Amazo123/Multi-Node-Infant-Cry-Detection/hardware_images/VIEW_ALL_SCHEMATICS.html

# ⚡ Master Hardware Wiring Schematics (Pixel-Perfect Trace-Accurate)

These schematics represent the true, unapproximated electrical pinout for all 5 microcontrollers and modules in the system. Every wire connects to its exact GPIO, power rail, or passive component without any AI hallucination or crossed traces.

## 1. Central Intelligence Hub ESP32-S3-WROOM-1 N16R8

2.4" ILI9341 SPI TFT + TP4056 USB-C Charger + 5V Step-Up Boost + 3000mAh Battery + 4 Capacitors + 1 Resistor (Buzzer Removed)

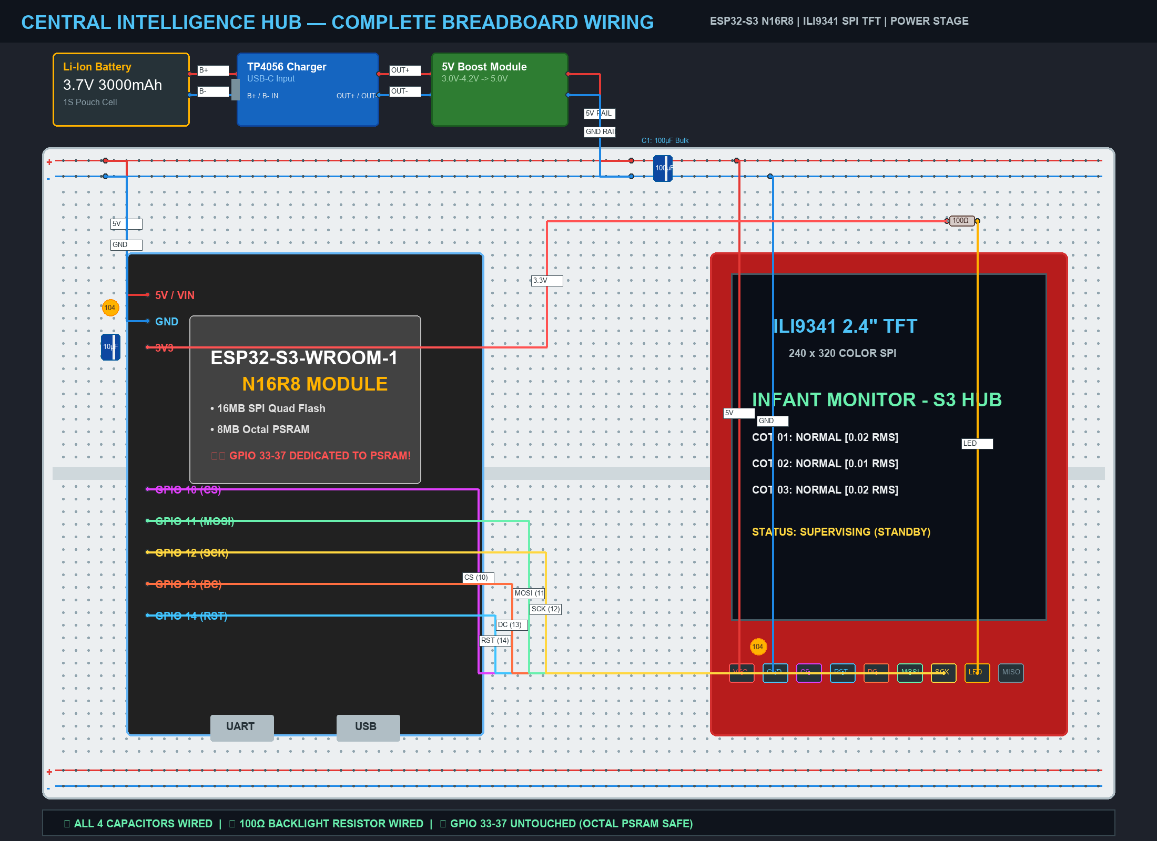
[picture p1: hardware_images/central_hub_breadboard_wiring.png]
Central Hub Breadboard Wiring


## 2. Cot Sensing Nodes (Cots 1, 2, 3) ESP32-C3 RISC-V

INMP441 24-bit I2S MEMS Mic + 2-LED Status (Active-LOW Blue on GPIO 9, Active-HIGH Red on GPIO 4) + Battery ADC Divider + TP4056 + 5V Boost + 2000mAh Battery

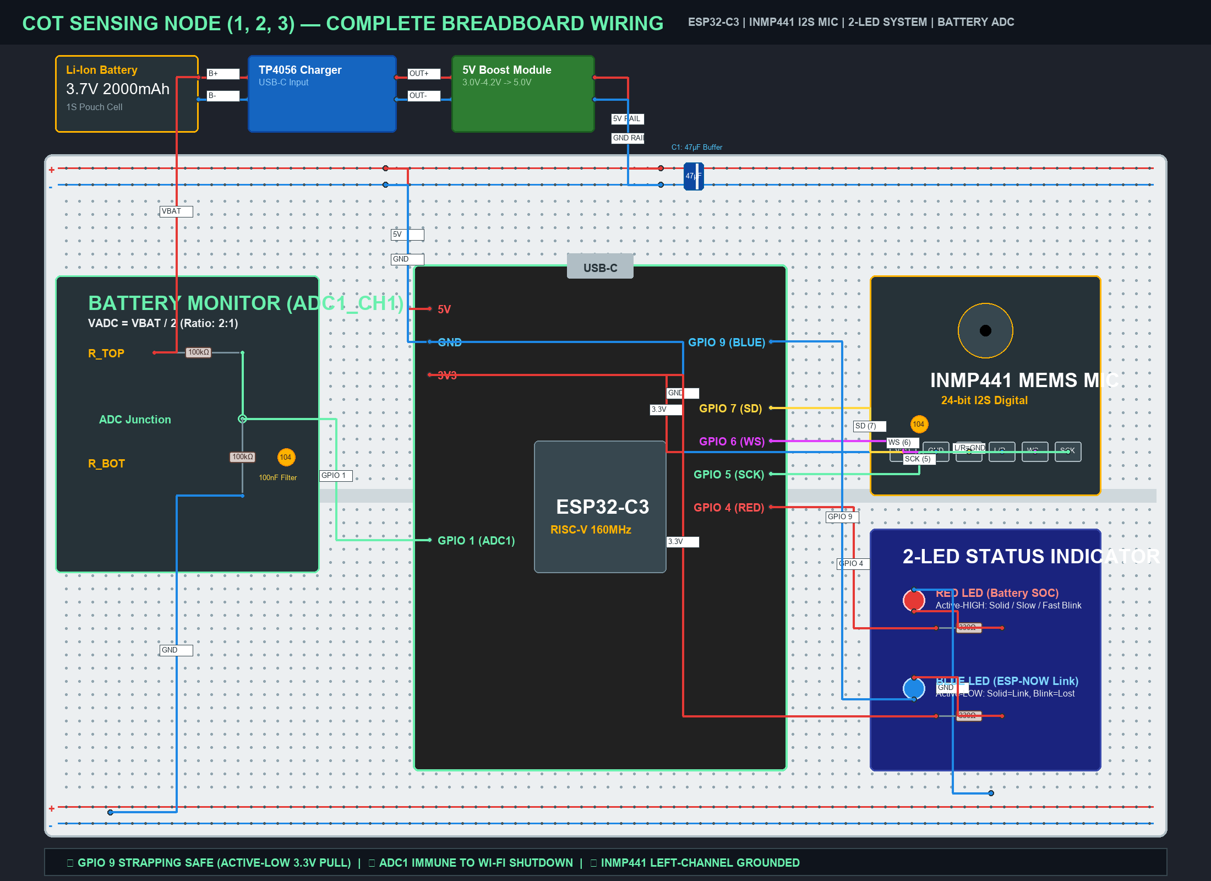
[picture p2: hardware_images/cot_node_breadboard_wiring.png]
Cot Node Breadboard Wiring


## 3. Caregiver Wearable Alert Wristband ESP32-C3 SuperMini

SSD1306 0.96" I2C OLED (GPIO 4/5) + IRLML2502TR SOT-23 N-MOSFET (Gate GPIO 3) + 10mm ERM Motor + 1N5819 Snubber Diode + 100Ω & 10kΩ Resistors + 500mAh LiPo

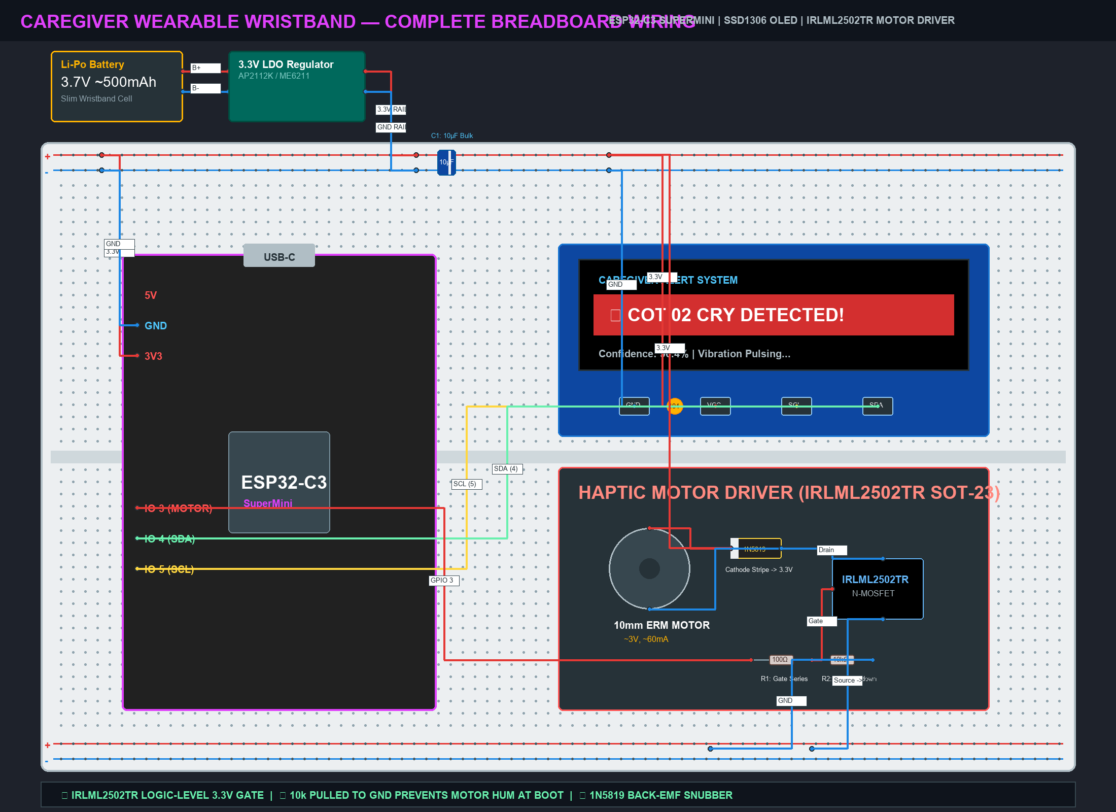
[picture p3: hardware_images/wearable_breadboard_wiring.png]
Caregiver Wearable Breadboard Wiring
