Amazo123/Multi-Node-Infant-Cry-Detection/HARDWARE_COMPONENTS_DETAILED_SPECIFICATION.pdf

# MULTI-NODE INFANT CRY DETECTION SYSTEM

1. Subsystem A: Cot Sensing Listening Nodes (3 Cot Units Total) | QUANTITY: 3 IDENTICAL NODES

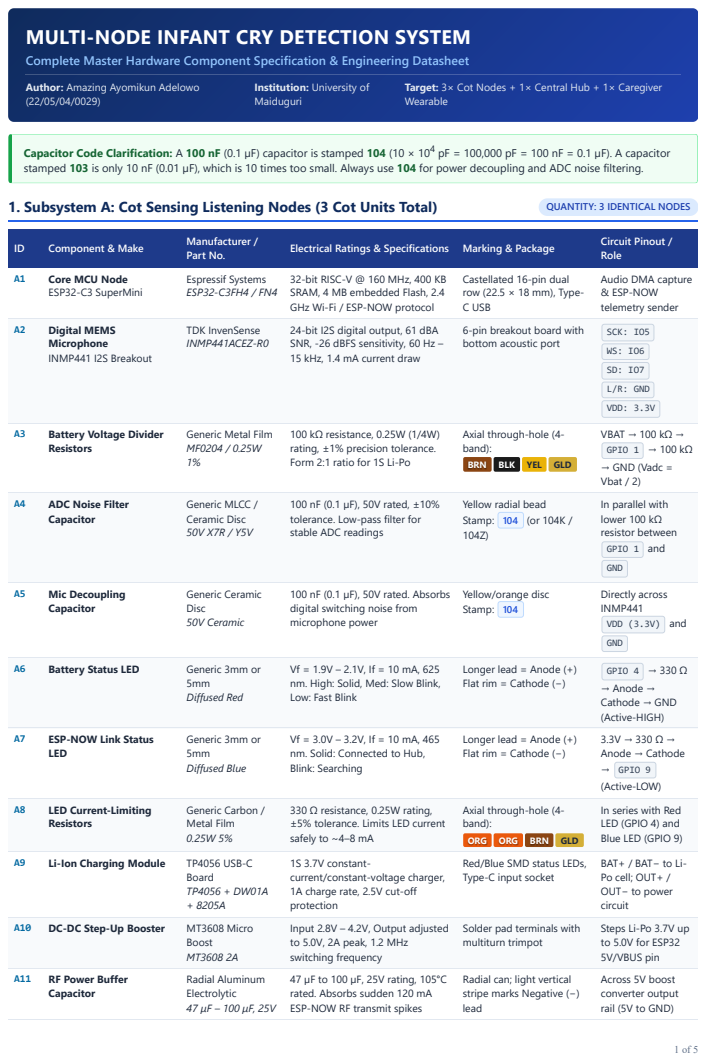
[picture p4: page 1]
Component & Make; Manufacturer / Part No.; Electrical Ratings & Specifications; Marking & Package; Core MCU Node; ESP32-C3 SuperMini; Espressif Systems ESP32-C3FH4 / FN4; Digital MEMS; Microphone INMP441 I2S Breakout; TDK InvenSense INMP441ACEZ-R0; Battery Voltage Divider; Resistors; Generic Metal Film MF0204 / 0.25W 1%; BRN; BLK; YEL GLD; ADC Noise Filter; Capacitor; Generic MLCC / Ceramic Disc 50V X7R / Y5V; Mic Decoupling; Generic Ceramic Disc 50V Ceramic; Battery Status LED; Generic 3mm or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

Complete Master Hardware Component Specification & Engineering Datasheet

Author: Amazing Ayomikun Adelowo

Institution: University of
Maiduguri

Target: 3× Cot Nodes + 1× Central Hub + 1× Caregiver
Wearable

4 pF = 100,000 pF = 100 nF = 0.1 µF). A capacitor

Capacitor Code Clarification: A 100 nF (0.1 µF) capacitor is stamped 104 (10 × 10
stamped 103 is only 10 nF (0.01 µF), which is 10 times too small. Always use 104 for power decoupling and ADC noise filtering.

Circuit Pinout /
Role
Audio DMA capture
& ESP-NOW
telemetry sender

32-bit RISC-V @ 160 MHz, 400 KB
SRAM, 4 MB embedded Flash, 2.4
GHz Wi-Fi / ESP-NOW protocol
24-bit I2S digital output, 61 dBA
SNR, -26 dBFS sensitivity, 60 Hz –
15 kHz, 1.4 mA current draw

Castellated 16-pin dual
row (22.5 × 18 mm), Type-
C USB
6-pin breakout board with
bottom acoustic port

SCK: IO5
L/R: GND
VDD: 3.3V
VBAT → 100 kΩ →
GPIO 1 → 100 kΩ
→ GND (Vadc =
Vbat / 2)
In parallel with
lower 100 kΩ
resistor between
GPIO 1 and
GND
Directly across
INMP441
VDD (3.3V) and

100 kΩ resistance, 0.25W (1/4W)
rating, ±1% precision tolerance.
Form 2:1 ratio for 1S Li-Po

Axial through-hole (4-
band):

100 nF (0.1 µF), 50V rated, ±10%
tolerance. Low-pass filter for
stable ADC readings

Yellow radial bead
Stamp: 104 (or 104K /

100 nF (0.1 µF), 50V rated. Absorbs
digital switching noise from
microphone power

Yellow/orange disc
Stamp: 104

nm. High: Solid, Med: Slow Blink,
Low: Fast Blink

Longer lead = Anode (+)
Flat rim = Cathode (−)

GPIO 4 → 330 Ω
→ Anode →
Cathode → GND
(Active-HIGH)
Anode → Cathode
→ GPIO 9
(Active-LOW)
In series with Red
LED (GPIO 4) and
Blue LED (GPIO 9)
BAT+ / BAT− to Li-
Po cell; OUT+ /
OUT− to power
circuit
Steps Li-Po 3.7V up
to 5.0V for ESP32
5V/VBUS pin
Across 5V boost
converter output
rail (5V to GND)

nm. Solid: Connected to Hub,
Blink: Searching

330 Ω resistance, 0.25W rating,
±5% tolerance. Limits LED current
safely to ~4–8 mA
1S 3.7V constant-
current/constant-voltage charger,
1A charge rate, 2.5V cut-off
protection
Input 2.8V – 4.2V, Output adjusted
to 5.0V, 2A peak, 1.2 MHz
switching frequency
47 µF to 100 µF, 25V rating, 105°C
rated. Absorbs sudden 120 mA
ESP-NOW RF transmit spikes

Red/Blue SMD status LEDs,
Type-C input socket

Solder pad terminals with
multiturn trimpot

Radial can; light vertical
stripe marks Negative (−)
lead

ID | Component & Make | Manufacturer / Part No. | Electrical Ratings & Specifications | Marking & Package | Circuit Pinout / Role
A12 | 1S Li-Po Battery Cell | Rechargeable Li-Po Pouch Model 103450 / 803450 | 1S 3.7V nominal, 2000 mAh capacity, integrated PCM protection board against short-circuits | Flat pouch with pre-crimped red/black lead wires | Connects to TP4056 B+ and B− terminals

Cot Node Strapping Pin Note: GPIO 9 controls the ESP32-C3 boot mode. Our Blue LED design (3.3V → 330 Ω → Anode → Cathode → GPIO 9) naturally pulls the pin HIGH during power-up, ensuring normal SPI flash boot. Do not short GPIO 9 directly to ground on power-on or the chip

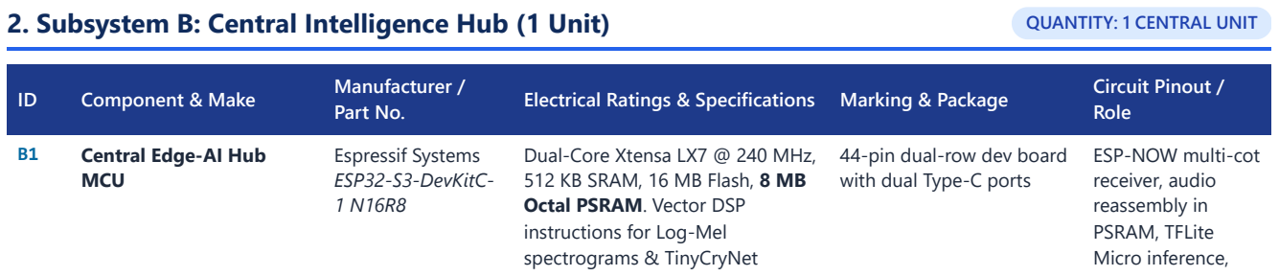
[picture p5: figure]
Component & Make; Manufacturer / Part No.; Electrical Ratings & Specifications; Marking & Package; Circuit Pinout / Role; Central Edge-AI Hub; MCU; Espressif Systems ESP32-S3-DevKitC- 1 N16R8; Dual-Core Xtensa LX7 @ 240 MHz, 512 KB SRAM, 16 MB Flash, 8 MB Octal PSRAM. Vector DSP instructions for Log-Mel spectrograms & TinyCryNet; 44-pin dual-row dev board with dual Type-C ports; ESP-NOW multi-cot receiver, audio reassembly in PSRAM, TFLite Micro inference,

2. Subsystem B: Central Intelligence Hub (1 Unit) | QUANTITY: 1 CENTRAL UNIT

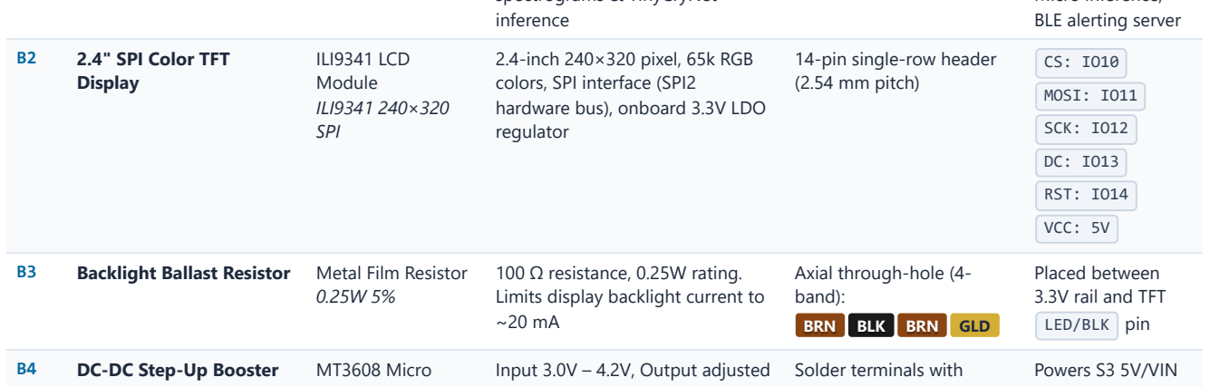
[picture p6: figure]
inference; BLE alerting server; 2.4" SPI Color TFT; Display; ILI9341 LCD Module ILI9341 240×320 SPI; 2.4-inch 240×320 pixel, 65k RGB colors, SPI interface (SPI2 hardware bus), onboard 3.3V LDO regulator; 14-pin single-row header (2.54 mm pitch); MOSI: IO11; SCK: IO12; RST: IO14; VCC: 5V; 100 Ω resistance, 0.25W rating. Limits display backlight current to ~20 mA; Axial through-hole (4- band):; BRN; BLK; GLD; Placed between 3.3V rail and TFT LED/BLK pin; DC-DC Step-Up Booster; MT3608 Micro; Input 3.0V – 4.2V, Output adjusted; Solder terminals with; Powers S3 5V/VIN

B3 | Backlight Ballast Resistor Metal Film Resistor

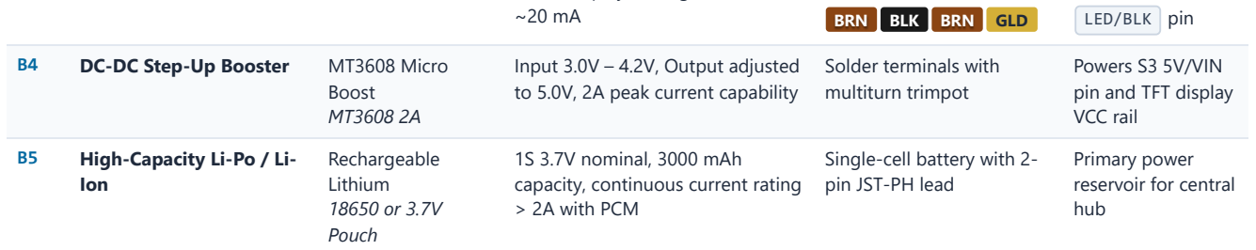
[picture p7: figure]
Boost MT3608 2A; to 5.0V, 2A peak current capability; multiturn trimpot; pin and TFT display VCC rail; High-Capacity Li-Po / Li-; Ion; Rechargeable Lithium 18650 or 3.7V Pouch; 1S 3.7V nominal, 3000 mAh capacity, continuous current rating > 2A with PCM; Single-cell battery with 2- pin JST-PH lead; Primary power reservoir for central hub

B6 | Bulk Decoupling Capacitor

Aluminum
Electrolytic
100 µF, 25V

100 µF capacitance, 25V rating, low ESR. Stabilizes 5V boost converter output

Radial can; stripe marks
Negative (−) lead

Placed across 5V
boost converter
output rail

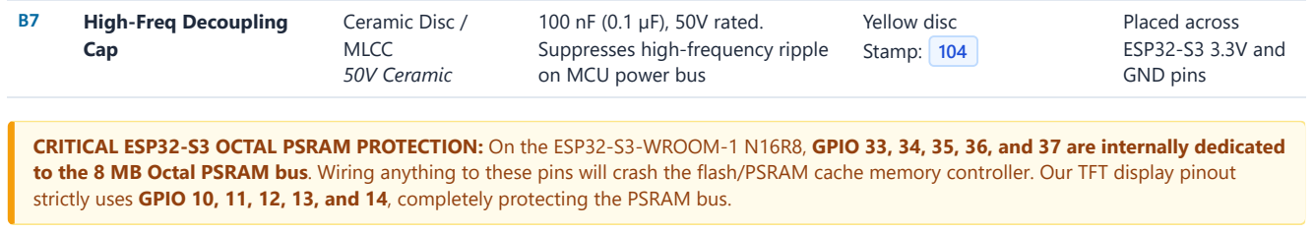
[picture p8: figure]
High-Freq Decoupling; Cap; Ceramic Disc / MLCC 50V Ceramic; 100 nF (0.1 µF), 50V rated. Suppresses high-frequency ripple on MCU power bus; Yellow disc Stamp: 104; Placed across ESP32-S3 3.3V and GND pins

CRITICAL ESP32-S3 OCTAL PSRAM PROTECTION: On the ESP32-S3-WROOM-1 N16R8, GPIO 33, 34, 35, 36, and 37 are internally dedicated to the 8 MB Octal PSRAM bus. Wiring anything to these pins will crash the flash/PSRAM cache memory controller. Our TFT display pinout strictly uses GPIO 10, 11, 12, 13, and 14, completely protecting the PSRAM bus.

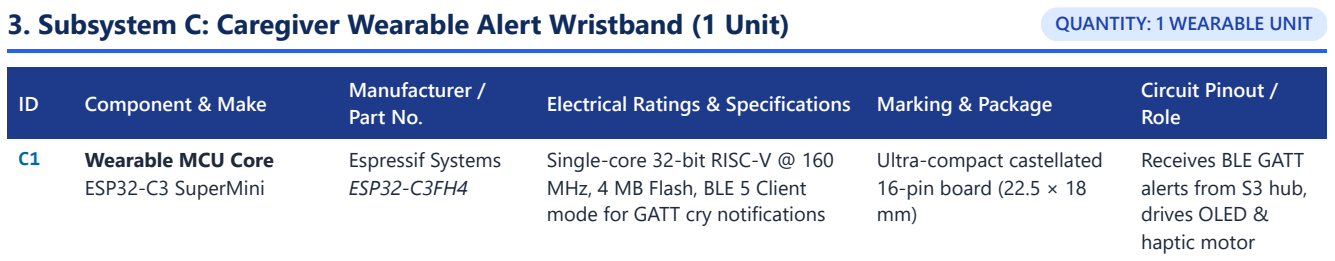
[picture p9: figure]
Component & Make; Manufacturer / Part No.; Electrical Ratings & Specifications; Marking & Package; Circuit Pinout / Role; Wearable MCU Core; ESP32-C3 SuperMini; Espressif Systems ESP32-C3FH4; Single-core 32-bit RISC-V @ 160 MHz, 4 MB Flash, BLE 5 Client mode for GATT cry notifications; Ultra-compact castellated 16-pin board (22.5 × 18 mm); Receives BLE GATT alerts from S3 hub, drives OLED & haptic motor

3. Subsystem C: Caregiver Wearable Alert Wristband (1 Unit) | QUANTITY: 1 WEARABLE UNIT

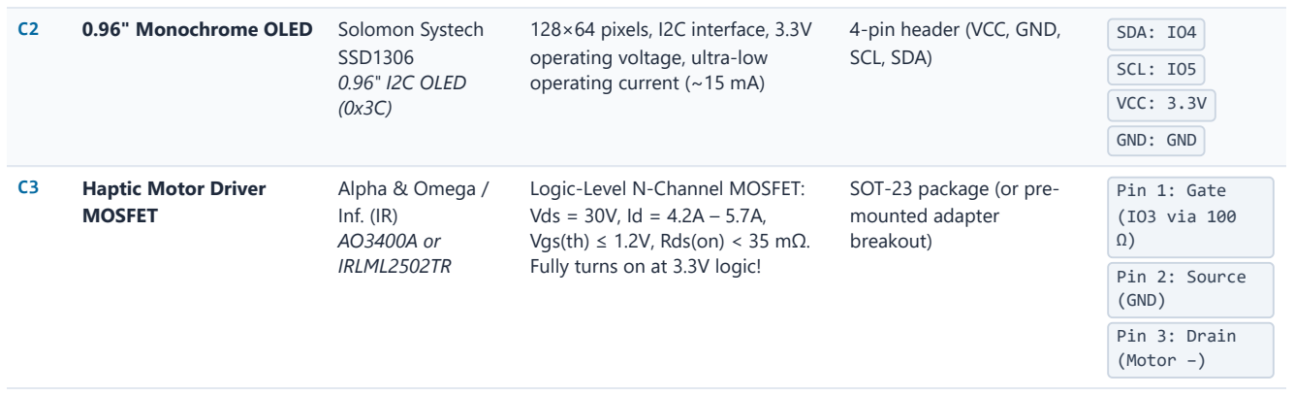
[picture p10: figure]
0.96" Monochrome OLED; Solomon Systech; SSD1306 0.96" I2C OLED (0x3C); 128×64 pixels, I2C interface, 3.3V operating voltage, ultra-low operating current (~15 mA); 4-pin header (VCC, GND, SCL, SDA); SDA: IO4; SCL: IO5; VCC: 3.3V; GND: GND; Haptic Motor Driver; MOSFET; Alpha & Omega / Inf. (IR) AO3400A or IRLML2502TR; Logic-Level N-Channel MOSFET: Vds = 30V, Id = 4.2A – 5.7A, Vgs(th) ≤ 1.2V, Rds(on) < 35 mΩ. Fully turns on at 3.3V logic!; SOT-23 package (or pre- mounted adapter breakout); Pin 1: Gate (IO3 via 100 Ω); Pin 2: Source (GND); Pin 3: Drain (Motor −)
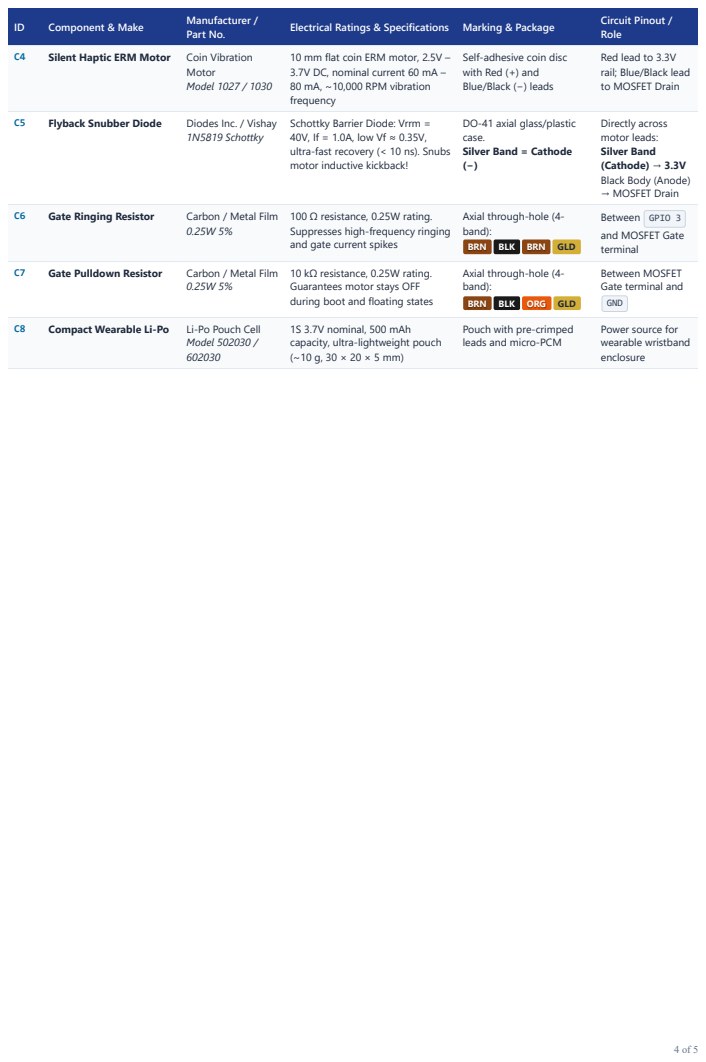
[picture p11: page 4]
Flyback Snubber Diode; Diodes Inc. / Vishay; 1N5819 Schottky; Gate Ringing Resistor; Carbon / Metal Film; BRN; BLK; GLD; Gate Pulldown Resistor; ORG; Compact Wearable Li-Po; Li-Po Pouch Cell; Model 502030 / 602030

ID | Component & Make | Manufacturer / Part No. | Electrical Ratings & Specifications | Marking & Package | Circuit Pinout / Role

C4 | Silent Haptic ERM Motor | Coin Vibration Motor Model 1027 / 1030 | 10 mm flat coin ERM motor, 2.5V – 3.7V DC, nominal current 60 mA – 80 mA, ~10,000 RPM vibration frequency | Self-adhesive coin disc with Red (+) and Blue/Black (−) leads | Red lead to 3.3V rail; Blue/Black lead to MOSFET Drain

Schottky Barrier Diode: Vrrm =
40V, If = 1.0A, low Vf ≈ 0.35V,
ultra-fast recovery (< 10 ns). Snubs
motor inductive kickback!

DO-41 axial glass/plastic
case.
Silver Band = Cathode

Directly across
motor leads:
Silver Band
(Cathode) → 3.3V
Black Body (Anode)
→ MOSFET Drain
Between GPIO 3
and MOSFET Gate
terminal
Between MOSFET
Gate terminal and
GND
Power source for
wearable wristband
enclosure

100 Ω resistance, 0.25W rating.
Suppresses high-frequency ringing
and gate current spikes

Axial through-hole (4-
band):
Pouch with pre-crimped
leads and micro-PCM

10 kΩ resistance, 0.25W rating.
Guarantees motor stays OFF
during boot and floating states

1S 3.7V nominal, 500 mAh
capacity, ultra-lightweight pouch

4. Subsystem D: Bench Prototyping Hardware, Interconnects & Consumables WORKSHOP ESSENTIALS

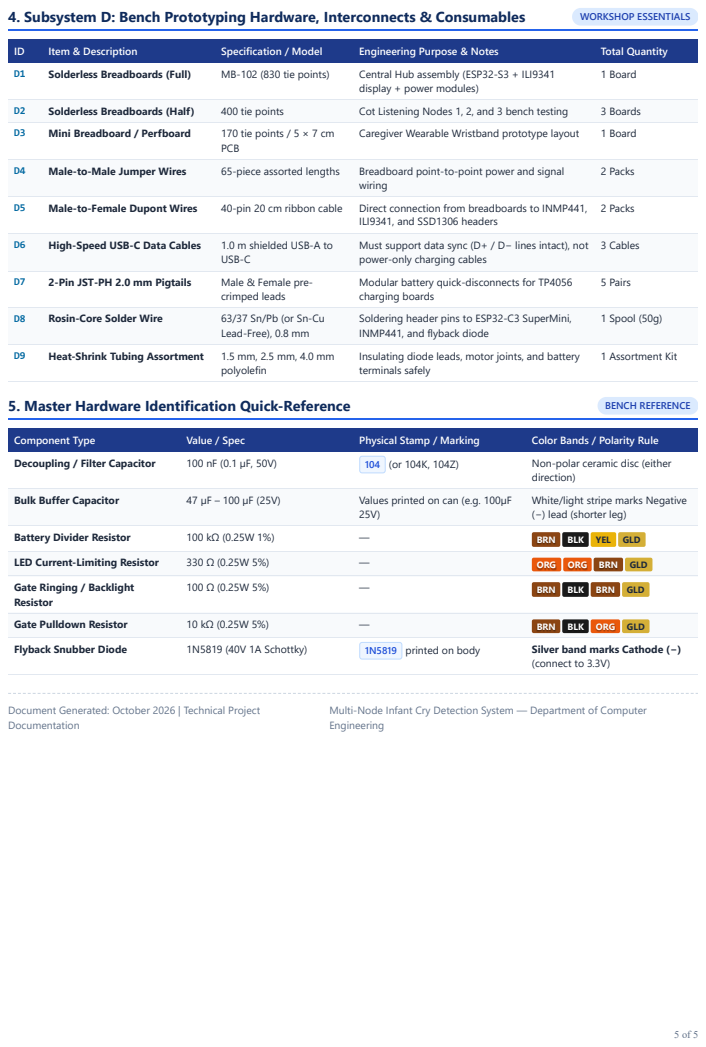
[picture p12: page 5]

ILI9341, and SSD1306 headers
Must support data sync (D+ / D− lines intact), not
power-only charging cables
Modular battery quick-disconnects for TP4056
charging boards
Soldering header pins to ESP32-C3 SuperMini,
INMP441, and flyback diode
Insulating diode leads, motor joints, and battery
terminals safely

direction)
White/light stripe marks Negative
(−) lead (shorter leg)

Document Generated: October 2026 | Technical Project
Documentation

Multi-Node Infant Cry Detection System — Department of Computer
Engineering
