Amazo123/Multi-Node-Infant-Cry-Detection/(commit log)

2026-09-30 feat: complete multi-node infant cry detection system architecture, firmware, models, and exact schematics
    [partitions_16MB.csv, partitions_4MB.csv]
2026-09-30 docs: add official Bill of Materials docx schedule with blank pricing columns
2026-10-23 fix(firmware): resolve false cry detection, packet loss, and full-screen landscape display
    - Node: add DC-coupled variance-based RMS to eliminate INMP441 DC offset
    - Node: implement flow-controlled ESP-NOW burst with ESP32 core 3.x send callback
    - Hub: add DC bias subtraction in PCM-to-float audio pipeline
    - Hub: enhance DSP acoustic discrimination model to reject broadband noise, speech, and whistles
    - Hub: configure ILI9341 320x240 rotation 2 with flicker-free differential rendering
    - Docs: add system wiring guide, hardware schematics, component specs, and simulations
    [01_inmp441_audio_plotter.ino, 05_central_hub_ili9341_test.ino, central_hub_s3.ino, dsp_mel_extractor.cpp, dsp_mel_extractor.h, esp_now_responder_probe.ino]
